RobotCrazy/Self-Driving-Car/3D Print Files/CE3PRO_Chassis_1.3mf

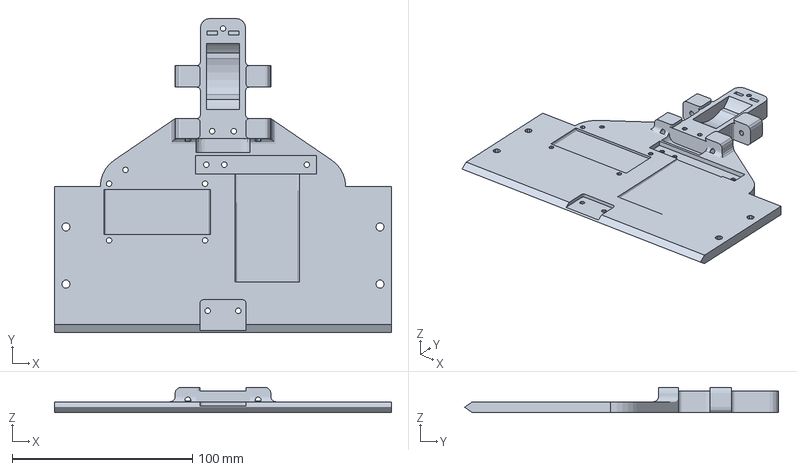
[picture p42: CAD file, 2024-04-17]
3D Print Files/CE3PRO_Chassis_1.3mf
186.8 x 173.9 x 14.0 mm
