RobotCrazy/Self-Driving-Car/3D Print Files/BothDifferentials.3mf

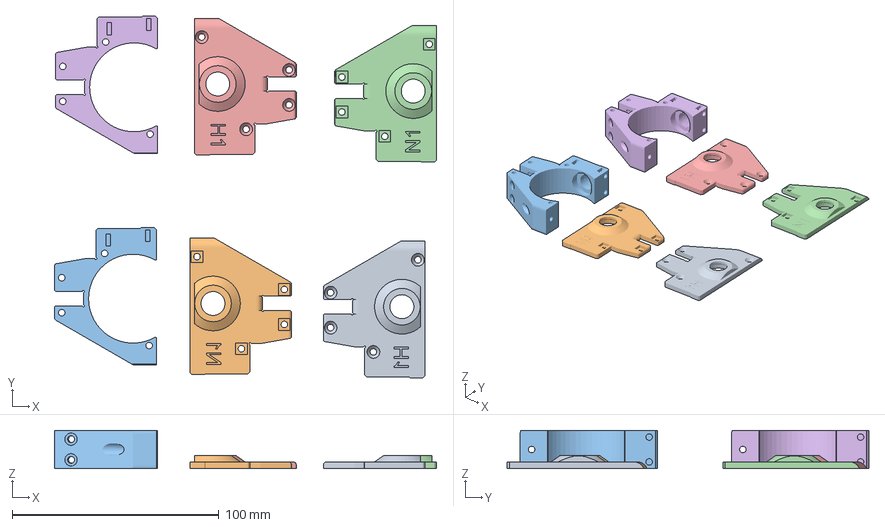
[picture p43: CAD file, 2024-04-17]
3D Print Files/BothDifferentials.3mf
184.8 x 174.9 x 18.5 mm
DiffCaseFrontMirror_1.stl
DiffCaseFrontMirror_2.stl
DiffCaseFrontMirror.stl
DiffCaseNutSide.stl
DiffCaseHeadSide.stl
DiffCaseCentralPart.stl
